96boards/96boards-uart/96boards-uart-bom-test.xlsx

Sheet: BOM
Bill of Materials
96Boards UART Rev v0.5
Reference | Qty | Value | Seeed SKU | Mfr | Mfr Part # | Colour
R1 | 1 | 390R | 301010297
R2 | 1 | 620R | 301010210
R3 R4 R7 R8 | 4 | 220R | 301010163
R9 R10 | 2 | 22R | 301010289
R5 | 1 | 1k | 301010298
R6 R11 | 2 | 10k | 301010299
C5 C6 | 2 | 39pF | 302010126
C4 C7 | 2 | 100nF | 302010138
C1 C2 C3 | 3 | 1uF | 302010139
D2 | 1 | +5V | 304090042 | Everlight | 19-217-R6C-AL1M2VY-3T | Red
D3 D4 | 2 | TX, RX | 304090044 | Everlight | 19-217-Y5C-AM1N1VY-3T | Yellow
D1 | 1 | USER | 304090045 | Everlight | 19-217-BHC-ZL1M2RY-3T | Blue
Q1 | 1 | S8050 | 305010017 | CJ | S8050
U1 | 1 | REG_1.8V | 310030016 | Torex | XC6206P182MR
U2 | 1 | FT230XS-R | 310070030 | FTDI | FT230XS-R
SW1 | 1 | RST | 311020004 | DIPTRONICS | DTSM-62K-S-V-T/R(SN431)
P1 | 1 | ~ | 320010015 | SUNTECH | ST-USB-001E
J2 | 1 | CONN_2X20 |  | Yxcon | P220-1220A0XMXXXX2
J1 | 1 | CONN_2X03 |  | Yxcon | P220-1203A0XMXXXX2
J1 | 2 | 2mm Shunt |  | Harwin | M22-1900005
 |  |  |  | Note | Select components as appropriate for cost reductions
 |  |  |  |  | Seeed OPL components have been selected where possible
 |  |  |  |  | Resistors and Capacitors are all 0603 footprint

Sheet: PCB
PCB Spec
96Boards UARTS Rev 1
Material | Standard FR-4
Size | 41mm x 14mm
PCB Layers | 2
Thickness | 1.6mm
Copper Weight | 1 oz
PCB Color | Green
Silkscreen | White – Topside only
Solder Mask | Via mask open
Minimum trace | Per gerber file
Minimum hole size | Per gerber file
Special requirements | Gerber will need to be panelized

Sheet: Test
Test Procedure
96Boards UARTS v1.1
Test jig PC test
1 2x20 2mm socket strip, such as Samtec SQT-120-01-L-D or Harwin M22-7142042
Wired up as follows. Pinout matches mating connector J2 on 96boards-uart:
Pin1: GND
Pin2: GND
Pin5: Short to Pin7
Pin7: Shorted to Pin5
Pin11: Shorted to Pin13
Pin13: Shorted to Pin11
Pin24: +5V |  | (Note: This differs from v1.0 which used pin 23)
Pin37: +5V
Pin39: GND
Pin40: GND
Test Plan
a. | Connect UUT to test jig
b. | Connect PC to UUT USB port
c. | Install shunts on UUT J1 between pins 1 & 3 and between pins 2 & 4
d. | Verify UUT Blue LED D1 (USER) and Red LED D2 (+5V) are lit
e. | Using FTDI FT_PROG utility, flash provided template configuration into UUT's FT230X device
f. | Using serial terminal emulator on PC, verify serial data sent is looped back and verify LEDs D3 (RX) and D4 (TX) flash on each keystroke
g. | Move shunts on UUT J1 to between pins 3 & 5 and between pins 4 & 6
h. | Using serial terminal emulator on PC, verify serial data sent is looped back
I. | Leave shunts installed on J1 pins 3 & 5 and pins 4 & 6 for shipping.
FT_PROG | http://www.ftdichip.com/Support/Utilities.htm
