96boards/96boards-uart/96boards-uart.pdf

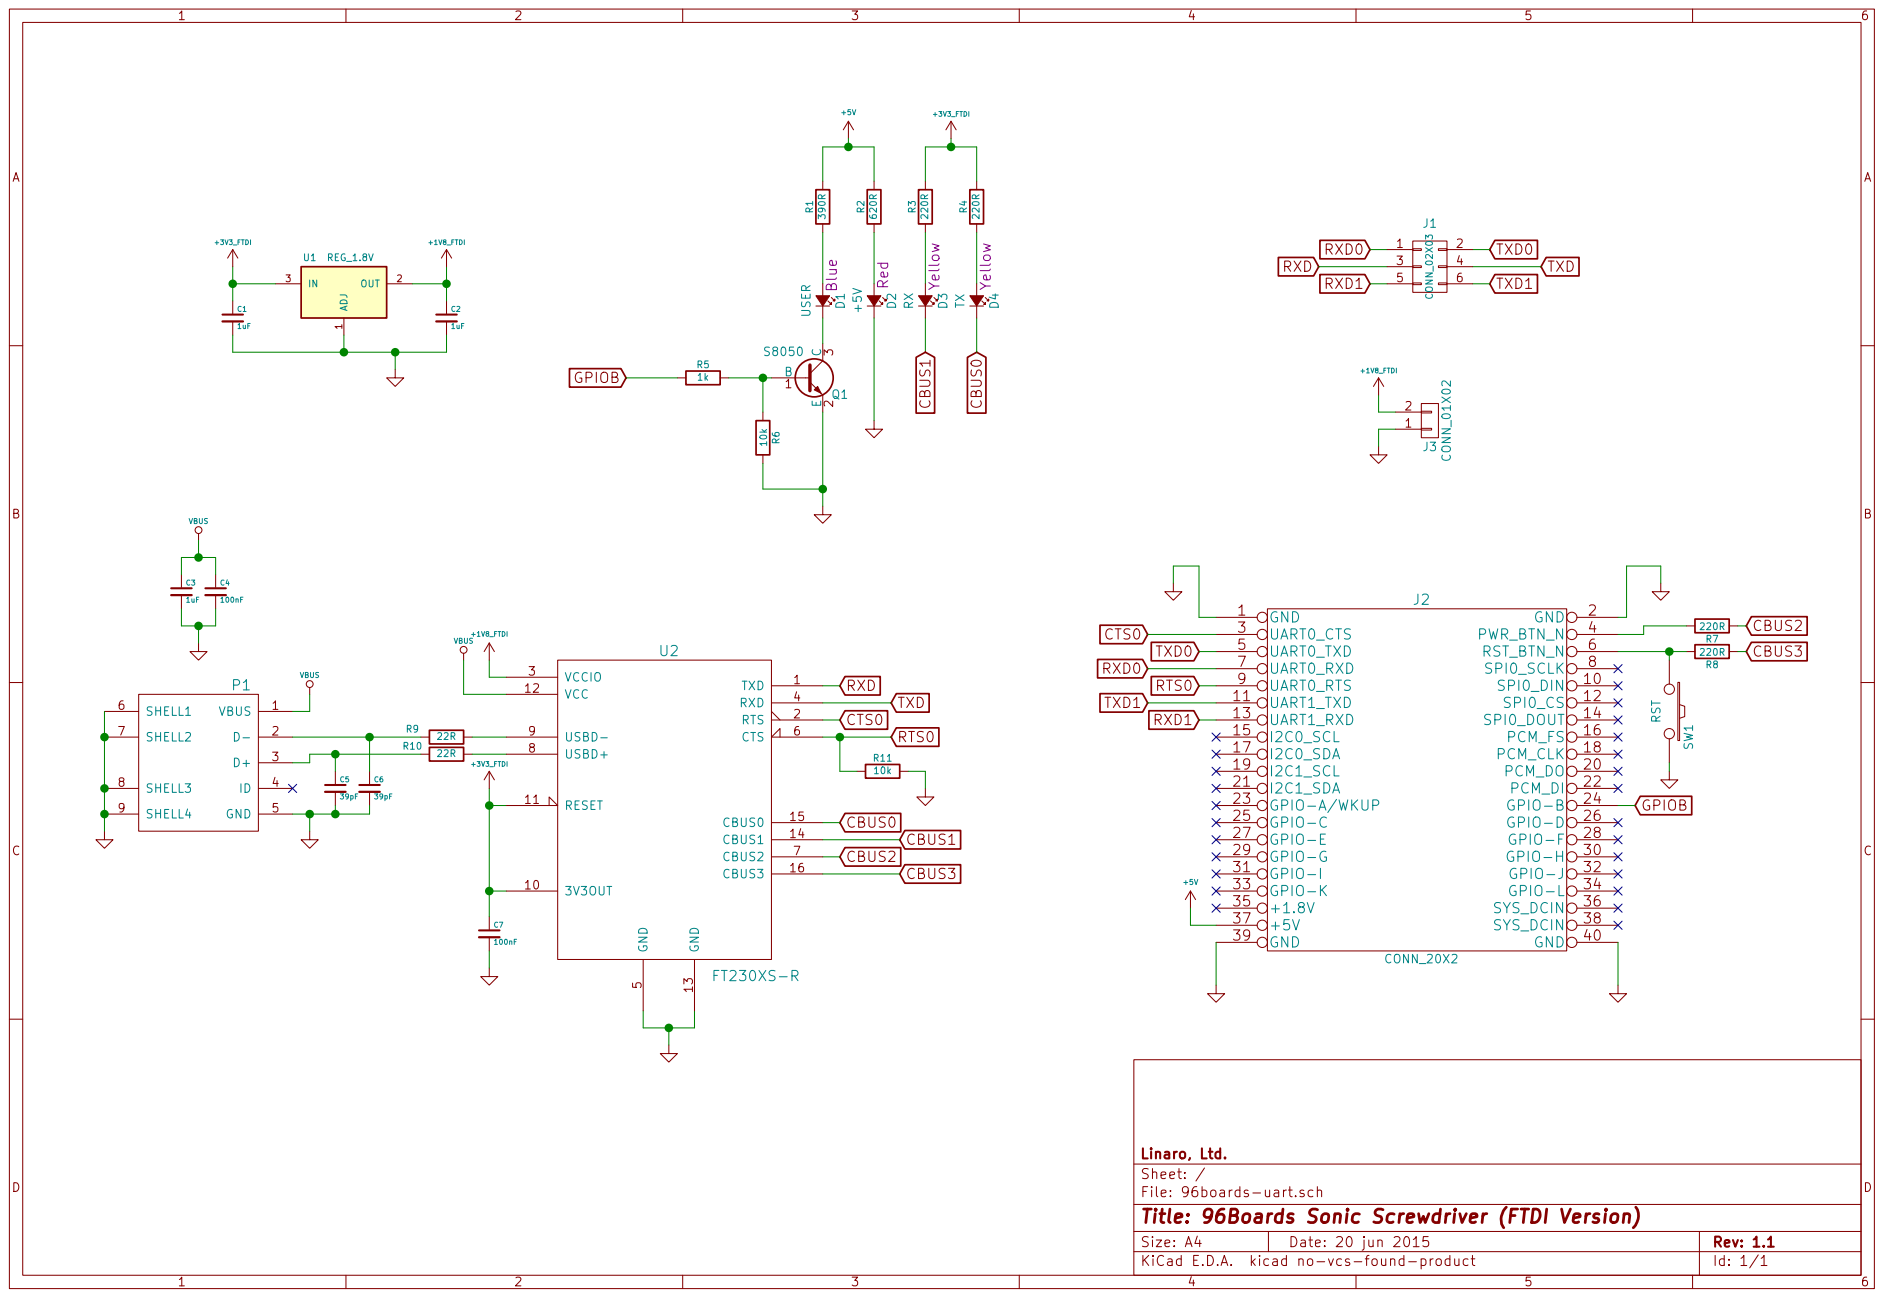
[picture p1: page 1]
