96boards/96boards-uart/(list of files, drawings)

Other design files:
96boards-uart.dsn
