96boards/96boards-uart/(threads)

Thread 2 (2017-06-21):

`96boardsctl reset` shows usage on Raspberry Pi

meermanr, 2017-06-21:
I've compiled 96boardsctrl on my ARM-based Raspberry Pi running [Raspbian Jesse Lite](https://www.raspberrypi.org/downloads/raspbian/) but found that it just shows its usage when I ask it to reset:

```
root@pi:/home/pi/96boards-uart/96boardsctl# ./96boardsctl reset

Usage: ./96boardsctl [OPTION]... command
Control the power button and reset lines with a 96boards USB console adaptor

  -h, --help                    Display this help and exit
  -o, --old                     Using old v0.3 prototype board
  -l, --list                    List available devices and exit
  -L, --long                    Use long 5s pulse, useful to force board to power off
  -p, --pulse-width=TIME        Length of signal pulse in ms
  -s, --serial <serial> Specify device to open by serial number

Commands:
  power                 Pulse the power button signal
  reset                 Pulse the reset button signal

This program causes the kernel's ftdi_sio driver to disconnect from the UART device
It can be reconnected by echoing the device name into /sys/bus/usb/drivers/ftdi_sio/bind
```

I believe this is because getopt_long() returns -1 when it has finished parsing options, but this is being assigned to an (unsigned) char which is always greater than zero, so the while loop never exits, causing the switch statements default to be chosen.

The following patch solved this for me:

```diff --git a/96boardsctl/96boardsctl.c b/96boardsctl/96boardsctl.c
index a2bead7..d2e0a7d 100644
--- a/96boardsctl/96boardsctl.c
+++ b/96boardsctl/96boardsctl.c
@@ -102,7 +102,7 @@ int main(int argc, char *argv[])

        ftdi_init(&ftdi);

-       while ((c = getopt_long(argc, argv, optstring, long_options, NULL)) >= 0) {
+       while ((c = getopt_long(argc, argv, optstring, long_options, NULL)) != (char) -1) {
                switch (c) {
                case 1:
                        if (count >= 3) {
```

glikely, 2020-04-08:
Should be resolved now

Thread 6 (2024-04-23):

Unknown components

OwOday, 2024-04-23:
What is:
SOT-23_Seeed
USB_MICRO_B_ST-USB-001E
Socket_Strip_SMD_2x20_Pitch2mm
SW_PUSH_DTSM_62K

OwOday, 2024-04-23:
I think the SOT might work with something like: https://wmsc.lcsc.com/wmsc/upload/file/pdf/v2/lcsc/2204191745_BL-Shanghai-Belling-BL9161G-33BPRT_C2999153.pdf though the voltage is off?
socket strip I think this can replace: https://wmsc.lcsc.com/wmsc/upload/file/pdf/v2/lcsc/2110100130_XKB-Connectivity-X4622WVS-2x20I-C40D64-E60_C2883345.pdf
I think this for the usb https://wmsc.lcsc.com/wmsc/upload/file/pdf/v2/lcsc/1912111437_SHOU-HAN-MicroQTJ_C404968.pdf
and this button: https://wmsc.lcsc.com/wmsc/upload/file/pdf/v2/lcsc/1810111053_Diptronics-DTSM-62K-V-T-R_C224978.pdf

The thing I am most worried about is the voltage regulator, I couldn't find an exact match since I don't know what exact properties it had. Do you think my replacement will break it?
