96boards/96boards-uart/(commit log)

2015-02-22 Fix zones to have the correct spacing
    The copper zones weren't getting added correctly because the tolerances
    were set too high.
    [96boards-uart.kicad_pcb]
2015-02-23 Fix silkscreening to show part designation
    The silkscreen was showing the part designator twice because I thought
    that I had to add it manually. It turns out that it gets automatically
    added when generating gerber files.
    Also minor tweaks to the routing to make the ground planes look nicer.
    [96boards-uart.kicad_pcb]
2015-02-24 New design to use max232 RS232 driver
    [96boards-uart.sch]
2015-02-25 Rework schematic for cp2104 evaluation module
    [96boards-uart.kicad_pcb, 96boards-uart.sch]
2015-03-02 Add footprint for cp2104-mini eval board
    Add a header layout for the cp2104-mini eval module from Silicon Labs.
    Putting it into a footprint instead of laying it out manually so that I
    don't mess it up later when reworking the layout.
2015-03-02 Add library for cp2104-mini and 96boards LS expansion
    Add schematic components for the expansion header and the CP2104-mini
    module.
2015-03-02 Rework schematic to use dedicated components
    The schematic was using generic pin rows for the 96board expansion and
    cp2401 eval kit. Rework to use the new dedicated schematics and
    footprints so that the schematic and PCB are easier to work with.
    [96boards-uart.kicad_pcb, 96boards-uart.sch]
2015-03-02 PCB sent to OSHPark for manufacture
    This version has been sent off. I've cleaned up a bunch of the
    silkscreen to make it more useful.
    [96boards-uart.kicad_pcb, 96boards-uart.sch]
2015-03-16 Add resister between 1.8V sense and 1.8V rail
    Don't want to accidentally burn out the USB->UART chip by attempting to
    drive 1.8V to ground.
    [96boards-uart.kicad_pcb, 96boards-uart.sch]
2015-03-26 Update the libraries to use my external kicad lib
    [96boards-uart.sch]
2015-05-26 Add a 1.8V regulator, jumpers for the UART, and LEDs
    This commit adds a 1.8V regulator to the board design. Originally it had
    been based on a simple diode drop, which may still be the better option,
    but it is a good idea to have the option of soldering down a regulator
    at this prototyping stage. Adding the pads doesn't add to the cost of
    the board.
    Also add jumper pads so that either UART0 or UART1 can be selected, and
    add LEDs to show the status of the voltage rails. Reset and power lines
    are wired up to GPIO0 & GPIO1, but those are also the lines for RX & TX
    activity. I've added LEDs to those lines to show when either go low, but
    also added jumper pads so it can be disconnected from reset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
    [96boards-uart.kicad_pcb, 96boards-uart.sch]
2015-05-27 Update solder mask to stay within cut lines
    This is the version submitted to SeeedStudio as the v0.2 build
    [96boards-uart.kicad_pcb]
2015-05-27 Rework schematic to use FTDI part instead of cp2104-mini module
    Seeedstudio keeps the FT230XS in stock for assembly onto boards. Replace
    the cp2104 module with the FTDI chip so that the entire board can be
    assembled by Seeed.
    [96boards-uart.sch]
2015-05-28 Implement feedback from Rob Herring on FTDI version
    Things fixed:
    - Tie #RESET to VCC
    - Rename power busses: VDD-->VBUS, VCC-->+3.3V, VIO-->+1.8V
    - Rework the LEDs. Use a transistor for the 1.8V_SENSE LED, and drive
    from +3.3V for the others.
    - Add pulldown to CTS
    - Add series resistor between CBUS pins and RST/PWR to avoid shorting a
    driven output pin to GND.
    - Add a 100nF bypass cap to 3V3OUT
    [96boards-uart.sch]
2015-05-29 Add datasheets for components on board
    Datasheets downloaded from Seeed OPL
    - LEDs
    - Ferrite bead
    - 1.8V regulator
    - FTDI USB UART
    - Buttons
    - Header rows
    - micro USB connectors
2015-05-31 Remove power sensing and power rail LEDs plus bugfixes
    Removes the sensing of power status because it will be unreliable, and
    rework the LEDs. This commit also is a work in progress for laying out
    the board for manufacture.
    [96boards-uart.kicad_pcb, 96boards-uart.sch]
2015-05-31 Finish layout of traces on v0.3 FTDI board
    Final layout of copper layers for v0.3 board. Shouldn't need any further
    changes before manufacturing.
    [96boards-uart.kicad_pcb]
2015-05-31 Swap out USB connector for one with posts
    The connector with posts should be more mechanically stable
    [96boards-uart.kicad_pcb]
2015-05-31 Reduce ground plane fragmentation by moving trace
    The trace between button pins doesn't need to be on the same layer as
    the trace to the button. By moving the trace to the other layer, it
    reduces how much the ground plane gets cut up.
    [96boards-uart.kicad_pcb]
2015-05-31 Move OPL part numbers to user field 1
    The BOM generation tool doesn't know how to sort user fields by name, so
    it puts things in the wrong columns if parts have user data in a
    different order. Move the OPL part number to user field 1 always so that
    it can be easily used for automatic BOM generation.
    [96boards-uart.sch]
2015-06-01 Add target for building Seeedstudio BOM file
2015-06-02 Update schematic with OPL part numbers
    Adds Seeed Studio OPL part numbers to the schematic components, and a
    Makefile target for generating a BOM in the format required by Seeed.
    [96boards-uart.sch]
2015-06-12 Add OPL part numbers for GS1 through GS4
    Add the OPL part numbers for the GS1-GS4 option headers.
    [96boards-uart.sch]
2015-06-16 Respond to comments from George and uprev to v0.4
    Rework the schematic to address comments provided by George:
    - Hardwire RTS/CTS lines. There is no need to make them selectable
    - Add an LED controlled by GPIOA
    - Remove power button
    - Replace direct lines with labels to make the schematic more readable
    [96boards-uart.sch]
2015-06-16 Fix typo in name of LS expansion connector footprint.
2015-06-16 Changes from review of v0.4 schematics
    Remove unnecessary caps
    Remove ferrite bead
    Consolidate parts to reduce BOM size
    Add pull down on GPIOA line
    [96boards-uart.kicad_pcb, 96boards-uart.sch]
2015-06-19 Layout for v0.4 version of sonic screwdriver
    Add the layout for the v0.4 schematic. New board dimensions are 42mm x
    14mm, and it no longer hangs over the edge of the board. The connectors
    have been changed to surface mount headers.
    A few changes to the schematic have also been made during the process of
    layout:
    - Remove the +1.8V and GND pins from J1, they were difficult to route
    - Switched back to driving LEDs from 1.8V. The transistor required for
    the GPIO line added extra components for little value, and the RED SMD
    LEDs that I'm using seem to be bright enough as-is.
    - Fill in part numbers for BOM generation
    [96boards-uart.kicad_pcb, 96boards-uart.sch]
2015-06-19 Change resistor values to 15R on 1.8V LEDs
    100R is too big. It won't allow the LEDs to light. Change to 15ohm. At
    the same time, change the TX and RX LEDs from red to yellow. May as well
    have a colourful board.
    [96boards-uart.sch]
2015-06-19 Update netlist and layout to pick up schematic parameters
    [96boards-uart.kicad_pcb]
2015-06-20 Power LEDs from the 3.3v rail
    The LEDs minimum 1.7v drop makes them very dim when powered from the
    1.8v rail. Move them to the 3.3v rail to give us more headroom. This is
    safe to do, even for 1.8v IO because the diode drop will protect the pin
    from being pulled higher than about 1.6v.
    [96boards-uart.sch]
2015-06-20 Partial revert of 80b476bb3b9, "Layout for v0.4 version of sonic screwdriver
    By reworking the layout, we may be able to get the original design
    feature implemented. Put back the v1.8 and GND pins in J1, and put the
    transistor driver back on the user LED.
    [96boards-uart.sch]
2015-06-22 Uprev design to latest unstable kicad
    Several components conflict with the new standard libraries. When opened
    with the new tool, the old components were "rescued" into a new library.
    Save this library before reworking everything to the new symbol names.
    [96boards-uart.sch]
2015-06-22 New layout for v0.5 of board
    Layout from George
    [96boards-uart.kicad_pcb, 96boards-uart.sch]
2015-06-22 Update schematic with part numbers and Seeed SKUs
    The part numbers were missing, and the Seeed SKUs were out of sync.
    [96boards-uart.sch]
2015-06-22 Uprev schematic and PCB layout to v1.0
    [96boards-uart.kicad_pcb, 96boards-uart.sch]
2015-06-22 Update values from netlist
    Pick up the latest R value changes and labels from the schematic into
    the PCB
    [96boards-uart.kicad_pcb]
2015-06-23 Fix fill zones
    The bottom layer fill zone was misaligned
    [96boards-uart.kicad_pcb]
2015-06-23 Update rule for packaging design files for Seeed
    The drill file isn't named the way Seeed wants it. Fix it.
2015-06-24 Relocated PCB components to use 100x100mm as the board top corner
    Minor tweaking of layout to exactly line up board with edge of 96board.
    [96boards-uart.kicad_pcb]
2015-06-25 Get rid of rescued components from kicad uprev
    The uprev to the latest KiCad caused some components to conflict with
    what is in the standard library. KiCad created 'rescued' components to
    keep the schematic readable, but it isn't really ideal because the
    standard footprints don't necessarily match. Fix up the schematic to use
    standard components and update the footprint assignments to match.
    Changed components: GND, +1.8V, +3.3V, R, Led_Small
    [96boards-uart.sch]
2015-06-25 Update layout to new components
    [96boards-uart.kicad_pcb]
2015-06-25 Trivial: Hide footprint text from schematic
    [96boards-uart.sch]
2015-06-25 Rework layout to use library footprints and clean up silkscreen
    Nearly there. This is the final draft of the layout for this board. It
    is pretty much ready to go for production after review.
    [96boards-uart.kicad_pcb]
2015-06-25 Move +1.8V and GND onto a separate header from the UART jumpers
    [96boards-uart.kicad_pcb, 96boards-uart.sch]
2015-06-29 FT230X configuration template
    Add the configuration template for programming the FT230X USB->UART interface.
2015-06-29 Address Seeed DFM comments
    - Change spacing of 0603 pads from 0.95mm to 0.63mm
    - Add orientation markers to U2
    - Move silkscreen labels away from USB connector
    [96boards-uart.kicad_pcb, 96boards-uart.sch]
2015-06-29 Adjust via sizes to 0.3mm
    Addresses DFM comment from Seeed.
    [96boards-uart.kicad_pcb]
2015-06-29 Add polarity indication to LEDs
    Seeed wasn't able to determine the polarity from the default KiCad LED
    footprint. Added a small 'C' to the cathode to make it clear.
    [96boards-uart.kicad_pcb]
2015-06-29 Include footprint positions in Seeed design package
2015-06-29 More fixups to address comments from Seeed
    - Move some silkscreen labels
    - Increase track width for VBUS
    - Improve markings on LEDs to indicate cathode
    [96boards-uart.kicad_pcb]
2015-06-29 Add paste layers to design package zipfile and fix bugs
    - Add paste layers to the Makefile
    - Fix name of edge cuts layer to match actual generated filename
    - Fixup BOM generation for Seeed Fusion PCBA service
2015-07-04 Add J1, J2 and P1 to pick-and-place x-y file
    [96boards-uart.kicad_pcb]
2015-07-04 Add filled zones to layout
    The gerber files sent to seeed were missing the filled zones. Add them back
    [96boards-uart.kicad_pcb]
2015-07-13 Add utility for controlling reset and power lines
    Very simple utility for controlling a 96board. Unfortunately it forces
    the console to disconnect when used and the driver needs to be poked to
    reconnect. Future work will fix this problem.
2015-07-13 Add a Makefile target for flashing the FTDI FT230X eeprom
    Provide a config file and makefile target to easily flash the FT230X
    device on the console board.
2015-07-14 Switch build to use CMake
    In an effort to make the application portable, change the build system
    to use CMake which gives some nice features like building in a separate
    directory, a make clean target that actually works, and a make install.
2015-07-14 Fix pin assignments on v0.3 prototype adaptor
    The pins were reversed; fix them.
2015-07-14 96boardsctl: Change pulse width to 1000ms
    100ms wasn't wide enough to trigger power on the HiKey. Make it a full
    second to ensure the board powers up.
2015-07-20 suffix 1.8v and 3.3v power rails with FTDI
    This patch renames ftdi specific power rails so that other components
    can really use more generic power rail names.
    [96boards-uart.sch]
2015-07-20 Make USB GND and VBUS power outputs on USB connector
    Making the pins outputs makes the DRC check pass for the schematic
2015-07-21 Update netlist and schematic to power rail name changes
    As the summary says, update the netlist and layout files to pull in the
    power rail name changes. Merely a mechanical change.
    [96boards-uart.kicad_pcb]
2015-07-21 Do not use GPIOA to control LED as it is wakeup pin
    This patch removes usage of GPIOA to control LED as it is a wakeup pin.
    Instead using GPIOB makes more sense.
    [96boards-uart.sch]
2015-07-21 Update netlist and layout to move GPIO pin
    Move LED to GPIOB so that GPIOA can be used as the wakeup interrupt pin
    [96boards-uart.kicad_pcb]
2015-07-21 Cleanup layout for v1.1 of board
    Lots of changes, simplifies some of the routing. Makes sure power rails
    are the right thickness and remove "Sonic Screwdriver" from the name.
    [96boards-uart.kicad_pcb]
2015-07-22 Reduce LED brightness and update footprints
    The red and blue LEDs are eyeball-searing bright. Increase the current
    limit resistors to get a more reasonable brightness. New values chosen
    to draw about 5mA across the LED instead of nearly 10.
    Also update schematic with the footprints actually used in the layout.
    [96boards-uart.sch]
2015-07-22 Increase size of U1 SOT-23 footprint
    Seeed found the footprint of U1 to be a tad too small for the part.
    Increase the pad sizes for U1 to match the values used in Seeed's Eagle
    library for the same part.
    [96boards-uart.kicad_pcb]
2015-07-22 Increase size of Q1 to SOT-23
    Q1 was using a completely incorrect footprint. Replace with the correct
    one. Unfortunately the correct footprint takes up more room and won't
    fit nicely into the same spot. Also need to rearrange the resistors and
    flip the LEDs to fit in nicely.
    [96boards-uart.kicad_pcb]
2015-07-22 Uprev to v1.1
    [96boards-uart.sch]
2015-07-23 Narrow outside shield pads on P1
    Narrow pads from 1.9mm to 1.3mm to reduce movement of P1 during solder
    reflow.
    [96boards-uart.kicad_pcb]
2015-07-24 Add 3d model for button
    [96boards-uart.kicad_pcb]
2015-07-24 Update schematic plot for v1.1 of the board
2015-07-24 Add manufacturing package for v1.1 of board
2015-07-29 Get rid of the unused 'mosfet' component library
    [96boards-uart.sch]
2015-07-31 Fixup silkscreen to show orientation of 96boards connector
    [96boards-uart.kicad_pcb]
2015-08-03 Fixup silkscreen and some trace rerouting
    Two fixups in this commit. There were a few silkscreen lines overlapping
    copper traces. They've been removed. Also the signals have been rerouted
    a bit to allow more of the board to be filled with ground plane.
    [96boards-uart.kicad_pcb]
2015-08-03 Drop the back silkscreen from the production .zip
    We're not asking for the back silkscreen to be printed, so don't include
    it.
    [96boards-uart.kicad_pcb]
2015-08-03 Update production .zip file to latest gerbers
2015-08-03 Add the BOM and Testplan file required by Seeed
    This file includes the updated BOM for the design as well as the test
    plan and test jig design.
    [96boards-uart-bom-test.xlsx]
2015-08-24 Add direct GPIO control
    Sometimes it is useful to control the CBUS pins directly. Add a 'gpio'
    command for directly setting the GPIO. Unfortunately, I do not know how
    to read from the FTDI chip if a pin is set as input or output, so
    setting a single GPIO will reset all the others back to being inputs.
2015-09-29 96boardsctl: Fix build for libftdi >= 1.0
    Currently CMakeLists.txt searches only for libftdi but on platforms
    where libftdi may be parallel installed this is insufficient. Fix
    the package detection and ensure we apply the detection results to
    the default build arguments.
    Also removes the check for libusb; 96boardsctl.c does not directly use
    this library so we can rely on pkg-config to get the link line right.
2015-09-29 96boardsctl: Fix --long pulse widths
    Currently --long is a nop; it sets pulse_ms to is original value. Fix
    this.
2016-11-25 96boardsctl: Provide a way to reattach after use.
    Conveniently libftdi documents its internal structures making it possible
    for us to make libusb calls to re-attach the kernel driver.
2018-11-12 96boardsctl: raspberry pi fix
    Getopt_long exits with a -1 when it's done parsing the cmd line.
    Seems the char on a raspberry pi is unsigned.
